anvaymathur/AttendanceTerminal/Assets/PCBPrice.png

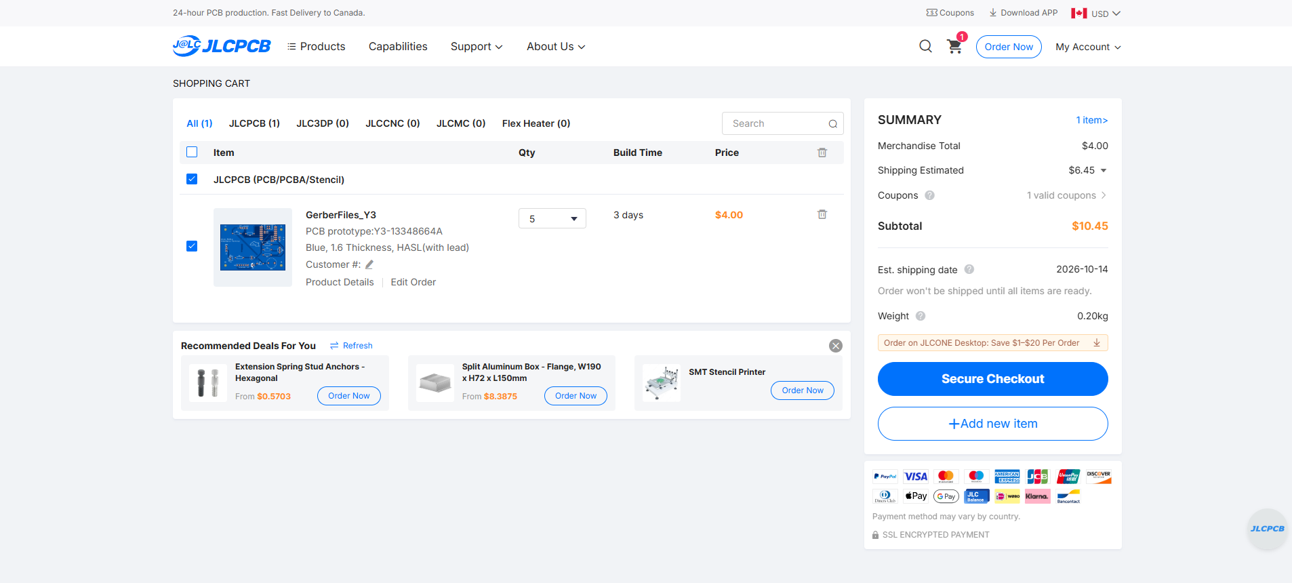
Assets/PCBPrice.png
