anvaymathur/AttendanceTerminal/BOM(PCB).csv

Item | Description | Preowned | # of Sets | #Pcs / Set | Price/Set (USD) | Item Total Price + Tax & Shipping (USD) | Supplier | URL
Megaboard PCB Printing with JLCPCB | PCB | FALSE | 1 | 5 | $4.00 | $10.45 | JLCPCB | https://github.com/anvaymathur/AttendanceTerminal/blob/main/Assets/PCBPrice.png
GM861S UART/USB QR Code Barcode Scanner Module | Scanner | FALSE | 1 | 1 | $12.06 | $19.36 | Aliexpress | https://www.aliexpress.com/item/1005004625447564.html?mp=1
2N7000 MOSFET Transistors | Transistor | TRUE | 1 | 50 | $3.25 | $3.25 | Aliexpress | https://www.aliexpress.com/item/1005010455877756.html?mp=1
Male Female Pin Header Single Row 2.54mm | Header Pins | TRUE | 1 | 20 | $10.51 | $10.51 | Aliexpress | https://www.aliexpress.com/item/1005003642939564.html?mp=1
Mini Vertical Micro Slide Switch | Power Switch | TRUE | 1 | 100 | $4.22 | $4.22 | Aliexpress | https://www.aliexpress.com/item/1005012254659077.html?mp=1
PH2.0 JST Male Female Plug Socket | Connectors | TRUE | 1 | 180 | $5.74 | $5.74 | Aliexpress | https://www.aliexpress.com/item/1005010504133815.html?mp=1
Aluminum Electrolytic Capacitor | Capcitor | TRUE | 1 | 40 | $3.01 | $3.01 | Aliexpress | https://www.aliexpress.com/item/1005011811368397.html?mp=1
Resistor Assortment Kit | Resistors | TRUE | 1 | 300 | $4.03 | $4.03 | Aliexpress | https://www.aliexpress.com/item/1005010779049132.html?mp=1
Diffused Cathode RGB LED | RGB LED | TRUE | 1 | 50 | $4.49 | $4.49 | Aliexpress | https://www.aliexpress.com/item/1005011597522333.html?mp=1
3V Active Buzzer Magnetic | Buzzer | TRUE | 1 | 10 | $3.29 | $3.29 | Aliexpress | https://www.aliexpress.com/item/1005012105971644.html?mp=1
IIC OLED Display Module | OLED Screen | TRUE | 1 | 1 | $3.34 | $3.34 | Aliexpress | https://www.aliexpress.com/item/1005008934254841.html?mp=1
seeed XIAO ESP32-S3 Mini Development Board Module | Microcontroller | TRUE | 1 | 1 | $16.90 | $16.90 | Aliexpress | https://www.aliexpress.com/item/1005008813495235.html?mp=1
3.7V 110mAh 301230 JST PH 2.0mm LiPo Battery | Battery | TRUE | 1 | 2 | $10.94 | $10.94 | Aliexpress | https://www.aliexpress.com/item/1005010595321382.html?mp=1
Grand Total: |  |  |  |  | $85.78 | Please note that most components are preowned and the grant only needs to cover the pcb and the scanner module.
