anvaymathur/AttendanceTerminal/BOM.md

# Attendance Scanner – bill of materials

<!-- Generated by Half Life from project cmuw1wt0004sm01osysrwzw41. Edits here are overwritten on the next sync. -->
<!-- Generated: 1970-01-01T00:00:00.000Z -->

> [!NOTE]
> This parts list is mirrored from [Half Life](https://halflife.hackclub.com). Editing it here will not change the platform's copy, and the next sync overwrites this file.

| Week | Tier | Parts funding |
| --- | --- | --- |
| Week 1 | Tier 1 | $30.00 |

_No parts listed yet._
