anvaymathur/AttendanceTerminal/CAD/MainAssembly.step

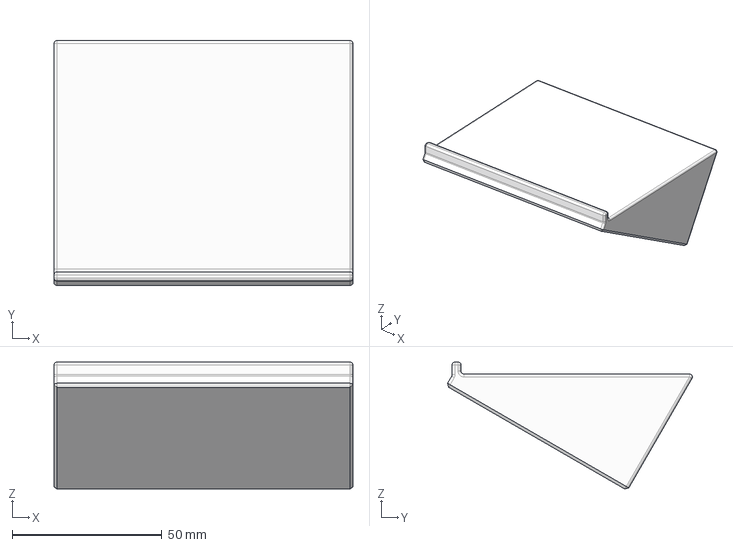
[picture p6: CAD file, 2026-10-19]
CAD/MainAssembly.step
100.0 x 81.9 x 42.5 mm
