anvaymathur/AttendanceTerminal/CAD/Lid.step

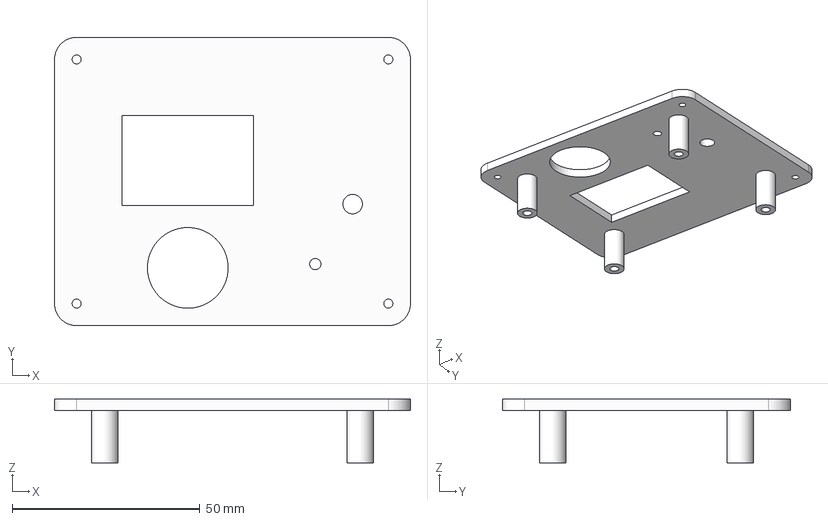
[picture p7: CAD file, 2026-10-19]
CAD/Lid.step
94.8 x 76.8 x 17.0 mm
