anvaymathur/AttendanceTerminal/CAD/Base.step

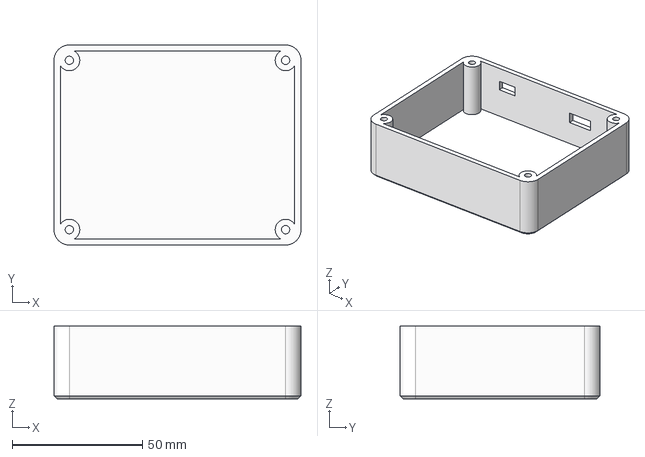
[picture p8: CAD file, 2026-10-19]
CAD/Base.step
94.8 x 76.8 x 28.0 mm
