anvaymathur/AttendanceTerminal/CAD/StandAngle.step

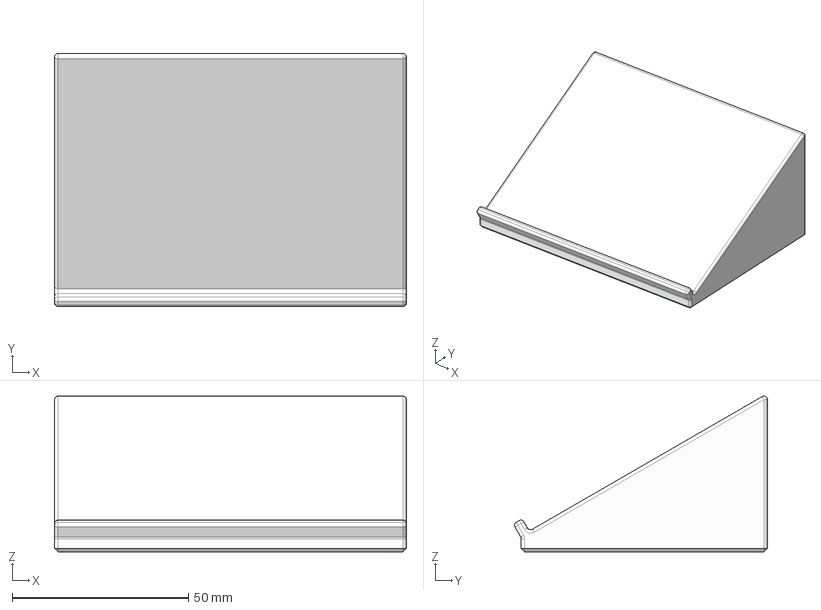
[picture p9: CAD file, 2026-10-19]
CAD/StandAngle.step
100.0 x 71.9 x 44.3 mm
