anvaymathur/AttendanceTerminal/(list of files, cad)

Other CAD files:
CAD/Base.stl
CAD/Lid.stl
CAD/MainAssembly.stl
CAD/StandAngle.stl
