anvaymathur/AttendanceTerminal/KiCad/AttendanceTerminalv2.kicad_pcb

## KiCad design KiCad/AttendanceTerminalv2.kicad_pcb (2026-10-10)

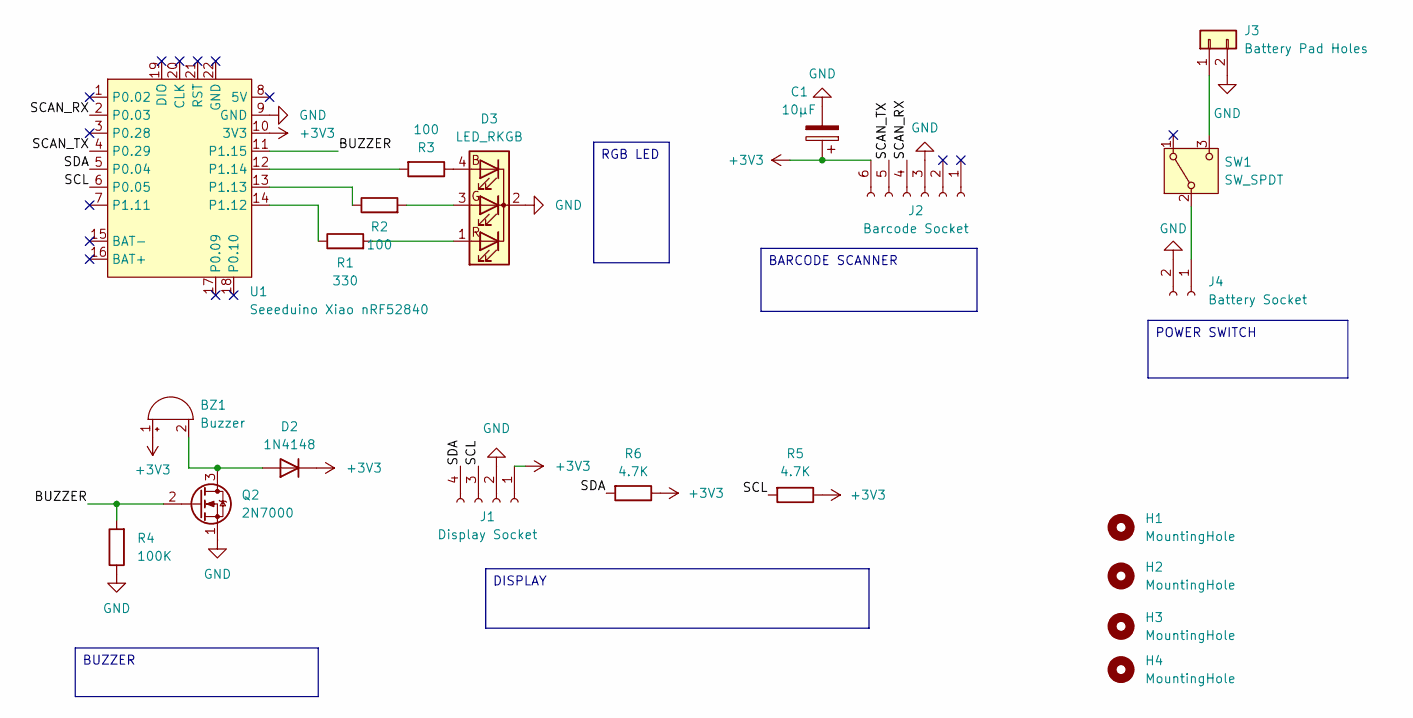
[picture p10: schematic AttendanceTerminalv2.kicad_sch]

Parts:
BZ1: Buzzer; Buzzer_12x9.5RM7.6
C1: 10µF; CP_Radial_D5.0mm_P2.00mm
D2: 1N4148; D_DO-35_SOD27_P7.62mm_Horizontal
D3: LED_RKGB; LED_D5.0mm-4_RGB_Wide_Pins
H1, H2, H3, H4: MountingHole; MountingHole_3.2mm_M3
J1: Display Socket; PinSocket_1x04_P2.54mm_Vertical
J2: Barcode Socket; PinHeader_1x06_P2.54mm_Vertical
J3: Battery Pad Holes; PinHeader_1x02_P2.54mm_Vertical
J4: Battery Socket; JST_PH_B2B-PH-K_1x02_P2.00mm_Vertical
Q2: 2N7000; TO-92_Inline
R1: 330; R_Axial_DIN0207_L6.3mm_D2.5mm_P10.16mm_Horizontal
R2, R3: 100; R_Axial_DIN0207_L6.3mm_D2.5mm_P10.16mm_Horizontal
R4: 100K; R_Axial_DIN0207_L6.3mm_D2.5mm_P10.16mm_Horizontal
R5, R6: 4.7K; R_Axial_DIN0207_L6.3mm_D2.5mm_P10.16mm_Horizontal
SW1: SW_SPDT; PinHeader_1x03_P2.54mm_Vertical
U1: Seeeduino Xiao nRF52840; Xiao_nRF52840_ACH

Connections:
+3V3: BZ1.1 (+), C1.1, D2.1 (K), J1.1, J2.6, R5.1, R6.1, U1.10 (3V3)
/BUZZER: Q2.2 (G), R4.2, U1.11 (P1.15)
/SCAN_RX: J2.4, U1.2 (P0.03)
/SCAN_TX: J2.5, U1.4 (P0.29)
/SCL: J1.3, R5.2, U1.6 (P0.05)
/SDA: J1.4, R6.2, U1.5 (P0.04)
GND: C1.2, D3.2 (K), J1.2, J2.3, J3.2, J4.2, Q2.1 (S), R4.1, U1.9 (GND)
unnamed: BZ1.2 (-), D2.2 (A), Q2.3 (D)
unnamed: D3.4 (BA), R3.1
unnamed: D3.3 (GA), R2.2
unnamed: D3.1 (RA), R1.2
unnamed: J3.1, SW1.3 (C)
unnamed: J4.1, SW1.2 (B)
unnamed: R1.1, U1.14 (P1.12)
unnamed: R2.1, U1.13 (P1.13)
unnamed: R3.2, U1.12 (P1.14)

Notes on the sheet:
DISPLAY
RGB LED
POWER SWITCH
BUZZER
BARCODE SCANNER

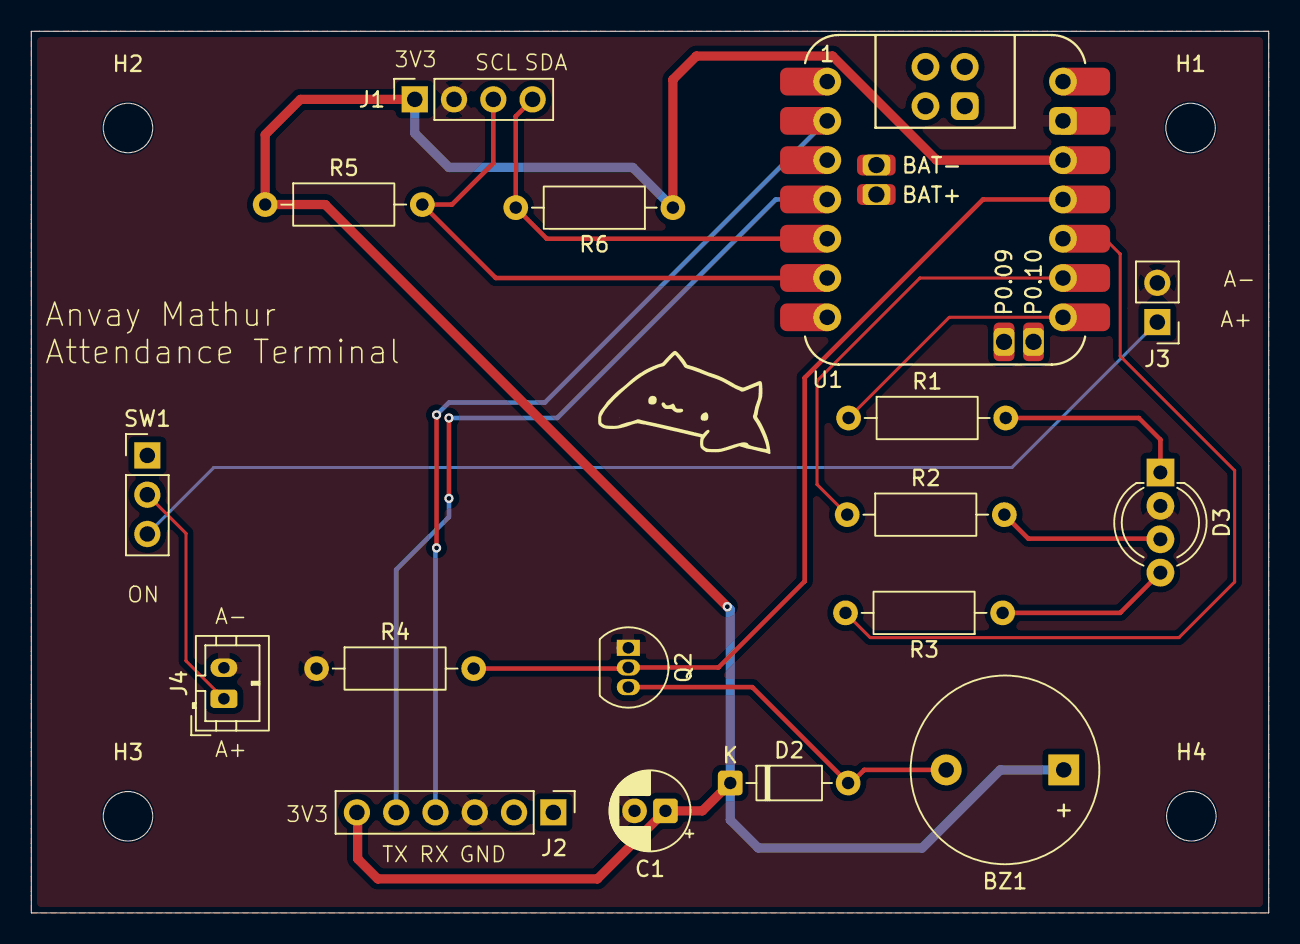
[picture p11: board AttendanceTerminalv2.kicad_pcb from above]

Board: 2 copper layers, 80.0 x 57.0 mm, 21 parts (0 on the bottom side), 16 nets.
