anvaymathur/AttendanceTerminal/JOURNAL(PCB).md

# Attendance Scanner – devlog

<!-- Generated by Half Life from project cmuw1wt0004sm01osysrwzw41. Edits here are overwritten on the next sync. -->
<!-- Generated: 2026-10-11T23:29:22.940Z -->

> [!NOTE]
> This devlog is mirrored from [Half Life](https://halflife.hackclub.com). Editing it here will not change the platform's copy, and the next sync overwrites this file.

> A compact, standalone barcode terminal for tracking school club attendance. Students scan the barcode on their existing school ID card, and the terminal sends the scan over Wi-Fi to a backend server that records attendance (to be built later). The whole device sits on a single custom PCB. An ESP32-S3 microcontroller handles Wi-Fi and control, a dedicated barcode scanner module reads the cards, and a small display, buzzer, and status LEDs give instant feedback on whether the scan worked. It runs on a rechargeable LiPo battery, charges over USB-C, and keeps working while plugged in, so you can carry it to any club meeting without needing an outlet.

| Week | Tier | Hours logged | Entries |
| --- | --- | --- | --- |
| Week 1 | Tier 1 | 19h | 6 |

## Contents

1. [2026-10-06 – Started working on the schematic of the power system. Working from the USB-C receptacle to the static protector, to the charger chip, to the battery socket. It allows the power to come in from the usb](#2026-10-06-started-working-on-the-schematic-of-the-power-sys)
2. [2026-10-07 – Finally finished the schematic. I first worked on making sure the power block was done. I ran the ERC on that specifically, and it had like 2 errors that needed to be fixed, but those were pretty easy](#2026-10-07-finally-finished-the-schematic-i-first-worked-on-)
3. [2026-10-07 – I restarted the entire schematic. I was talking to a close friend about the topic and telling him how much added complexity the power system adds and how I was thinking of making it run just on USB-C.](#2026-10-07-i-restarted-the-entire-schematic-i-was-talking-to)
4. [2026-10-10 – I started selecting the specific components I wanted to use so I could select the correct footprints. I basically only used AliExpress and then made sure the footprints on the schematic matched the ac](#2026-10-10-i-started-selecting-the-specific-components-i-wan)
5. [2026-10-11 – I wrote the firmware for the project. It is just the basic firmware for now, just to interact with the scanner and all the components. It has some more complex features, like stopping really quick sca](#2026-10-11-i-wrote-the-firmware-for-the-project-it-is-just-t)
6. [2026-10-11 – Finalised the exact material listings and made the BOM. Most of the components are pre-owned, or I will cover the cost myself, so I just tried to find the cheapest possible listings for them. I also f](#2026-10-11-finalised-the-exact-material-listings-and-made-th)

## Design

### 2026-10-06 – Started working on the schematic of the power system. Working from the USB-C receptacle to the static protector, to the charger chip, to the battery socket. It allows the power to come in from the usb

**1.5h**

Started working on the schematic of the power system. Working from the USB-C receptacle to the static protector, to the charger chip, to the battery socket. It allows the power to come in from the usb-c, with proper static protection as this can be missused. The charger chip is to charge the battery. The battery socket is where the battery will plug into. Also including the necessary resistors and capacitors.

Hour1Schematic

Hour1Schematic-3

### 2026-10-07 – Finally finished the schematic. I first worked on making sure the power block was done. I ran the ERC on that specifically, and it had like 2 errors that needed to be fixed, but those were pretty easy

**5h**

Finally finished the schematic. I first worked on making sure the power block was done. I ran the ERC on that specifically, and it had like 2 errors that needed to be fixed, but those were pretty easy to fix.

ERCWithErrors

It was basically, since I am just using a battery socket and a usb - c receptacle, KiCad didn't know where I was getting power from. So I just added power flags to the VSYS, GND, and VBUS tags so KiCad recognizes I am supplying power through those.

PowerFlag

Next, I worked on getting the ESP32 hooked up. For detecting battery voltage, since the battery goes up to 4.2V and the pin used to detect battery voltage on the ESP32 can handle up to 3.3v, I used 2 identical resistors to split the voltage in half, so in the software I can just double whatever input I get from that pin. I also used a tiny capacitor to smooth the inputs to the pin.

BatterySensorResistorSetup

Then I added the 6-pin connector for the barcode scanner; the 4-pin connector for the OLED screen; the buzzer and transistor, which is needed to amplify the voltage; and the red and green status LEDs.

Finished Schematic:
SchematicDone

No errors left in the Electrical Rules Checker (ERC) tool:
ERCNoErrors

### 2026-10-07 – I restarted the entire schematic. I was talking to a close friend about the topic and telling him how much added complexity the power system adds and how I was thinking of making it run just on USB-C.

**4h**

I restarted the entire schematic. I was talking to a close friend about the topic and telling him how much added complexity the power system adds and how I was thinking of making it run just on USB-C. Initially, I wanted to avoid that, but the complexity was just too high for me to continue with the schematic I had previously made. It was heavily influenced by tutorials, and it was too complex for my skill level (beginner). He told me that some boards already have built-in power management systems, so they will handle that for you. I realised that if I plan to actually make this project usable, I will need to use these boards. I researched and found the Seeed Studio XIAO ESP32S3

SeeedStudioXiaoBoard

With this new board, it was easier to restart the whole schematic than to go and delete my individual work. Since I removed some complexity there, I also switched to an RGB LED because that is something I have never used before and wanted to try using.

V2InitialMicroControllerSchematic

Then I worked on adding in the buzzer. I used fewer net labels this time, so it is easier for me to visualize what connects to what and where; this time, without the use of any tutorials (AI was used to check over my work to make sure I wasn't breaking it, but only after using the ERC).

V2CleanerBuzzerSchematic

Then adding the screen was pretty simple; I had to add my own pull-down resistors, but I knew how to do that. The barcode scanner was also very similar to the previous version, so I could easily make that without any help. And the same for the power switch. It still took me a while overall because I am still pretty inexperienced and had to restart more than once because I was doing something wrong. Now the schematic is finished!

v2DoneSchematicNoBatterySense

ERC passed:

v2ERCPassed

### 2026-10-10 – I started selecting the specific components I wanted to use so I could select the correct footprints. I basically only used AliExpress and then made sure the footprints on the schematic matched the ac

**5h**

I started selecting the specific components I wanted to use so I could select the correct footprints. I basically only used AliExpress and then made sure the footprints on the schematic matched the actual components. Then I moved on to actually getting the schematic into the PCB. I started arranging it, but then I realised that I wasn't accounting for stuff like the screen and how you can't have bigger components sitting underneath that. I also had to decide how I wanted the actual case to look and how the users would interact with the scanner and the LEDs and stuff. Here is what I initially had:

PCBArrangement1

Then I took some time to figure out how I wanted my case to look, how I wanted the user to interact with the scanner, and stuff. I decided the PCB was going to be angled upward, and the USB-C port would be out from the top. So after 2-3 tries, this is what I ended up with (The big square is the screen, the resistors are small enough to fit underneath):

PCBFinalArrangement

Then I did the routing; that took a while, and it is pretty messy. I might take some time to clean up the routing. I also added a GND zone fill to both the top and bottom layers. Here is the schematic:

PCBZoneFilled

I then added some silkscreen stuff, so here is the final schematic:

PCBFinal

3D:

PCBFinal3D

### 2026-10-11 – I wrote the firmware for the project. It is just the basic firmware for now, just to interact with the scanner and all the components. It has some more complex features, like stopping really quick sca

**1.5h**

I wrote the firmware for the project. It is just the basic firmware for now, just to interact with the scanner and all the components. It has some more complex features, like stopping really quick scans, which happens when the same code is scanned twice. And it turns off the screen and LED when inactive for more than 5 seconds, etc. [Here](https://github.com/anvaymathur/AttendanceTerminal/blob/main/Firmware/main.py) is the code; it logged 1hr and 33mins on hackatime:

FirmwarePt1

FirmwarePt2

FirmwarePt3

### 2026-10-11 – Finalised the exact material listings and made the BOM. Most of the components are pre-owned, or I will cover the cost myself, so I just tried to find the cheapest possible listings for them. I also f

**2h**

Finalised the exact material listings and made the BOM. Most of the components are pre-owned, or I will cover the cost myself, so I just tried to find the cheapest possible listings for them. I also finalised and finished the README. The BOM can be found in the BOM.csv file in the repo or at [this](https://docs.google.com/spreadsheets/d/1CIG54QZLjPgN8hb-R9MU0n-KgLEakrtmUqO80z-3FYI/edit?usp=sharing) link in the form of a Google Spreadsheet.

FinishedBOM

FinishedReadme
