anvaymathur/AttendanceTerminal/(commit log)

2026-10-10 Added Gerber and Drill Files from KiCad finished project
    [AttendanceTerminalv2-B_Cu.gbl, AttendanceTerminalv2-B_Mask.gbs, AttendanceTerminalv2-B_Paste.gbp, AttendanceTerminalv2-B_Silkscreen.gbo, AttendanceTerminalv2-Edge_Cuts.gm1, AttendanceTerminalv2-F_Cu.gtl, AttendanceTerminalv2-F_Mask.gts, AttendanceTerminalv2-F_Paste.gtp]
2026-10-10 Added extra KiCad files
    I don't know if its needed
    [AttendanceTerminalv2.kicad_pcb, AttendanceTerminalv2.kicad_sch]
2026-10-11 PCB Price Screenshot (need for link)
2026-10-11 Added BOM.csv
2026-10-19 CAD STEP
2026-10-19 Sync Attendance Terminal CAD from Half Life
2026-10-19 Individual Part CAD Files
2026-10-19 Re-Added BOM and JOURNAL from PCB week
    - I used the same repo for cad week and pcb week since it is the same project but it overwrote the files so I made 2 of them
